StefanRohringer/Magnetic-Fin-Gripper/zeichnungen/README.md

# Zeichnungen / Drawings

**Gültig ist nur die Basis V1.8.1.** Bei den älteren Basen (V1.7, V1.8) blieben einzelne Lamellen nach einem festen Griff hängen. V1.8.1 hat mehr Luft um die Lamellen und behebt das. Ältere Basen bitte nicht mehr drucken.

**Only base V1.8.1 is valid.** With the earlier bases (V1.7, V1.8) individual lamellae could get stuck after a firm grip. V1.8.1 has more clearance around the lamellae and fixes this. Please do not print older bases.

| Datei / File | Inhalt / Content |
|---|---|
| `Massblatt_V1.8.1.pdf` / `.png` | Basis V1.8.1 (gültig) – base V1.8.1 (valid) |
| `Massblatt_Lamelle_V1.6N.pdf` / `.png` | Fin-Ray-Lamelle V1.6-N – Fin-Ray lamella V1.6-N |
| `Massblatt_W2c_Fingernagel.pdf` / `.png` | W2c-Fingernagel – W2c fingernail |
| `Loetbruecken_A0_A1.png` | Lötbrücken A0/A1 – address solder jumpers |

Die Spalte „V1.7“ / „V1.8“ im Maßblatt V1.8.1 dient nur zum Vergleich. – The V1.7 / V1.8 columns in the V1.8.1 drawing are for comparison only.
