StefanRohringer/Magnetic-Fin-Gripper/zeichnungen/Massblatt_W2c_Fingernagel.pdf

Magnet wie heute

TPU-Lamelle wie V1.6-N,
ab y 52 massiv

PLA-Nagel

93,5

## Seitenansicht ganz zu (gemessener Spalt), Schnitt durch die Lamellen

0,3

2,44

Stift Ø1,75

## Nagel und Zapfen (2:1)

1,2

21,9

## Vorderansicht, eine Basis (Greifseite)

# W2c Fin-Ray mit PLA-Fingernagel

Für sehr kleine Elektronikteile · TPU-Lamelle wie im Stand V1.8.1 (Lamelle V1.6-N) direkt in der Basis · PLA-Nagel je Basis auf beiden Lamellen, Stift aus 1,75-mm-Filament · Probe 19.10.2026 · Maße mm

## So sitzt der Nagel

Beide Lamellen einer Basis haben oben einen Zapfen (TPU).

Der Nagel wird von oben auf beide Zapfen geschoben und

mit einem Stück 1,75-mm-Filament quer durchgesteckt.

Das TPU klemmt den Stift (Loch 1,6), im PLA hat er Luft.

Der Nagel macht aus den zwei Lamellen einer Basis eine

harte Spitze; beide Sensoren dieser Seite bleiben.

Drucklage Nagel: Greiffläche auf dem Bett (Datei liegt so).

Druckteile je Greifer

W2c_Lamelle_TPU_2Stueck.stl, 2 ×

TPU 95A wie die Lamellen V1.6-N (8.1)

W2c_Nagel_PLA_2Stueck.stl, 1 ×

PLA+, Schicht 0,12 mm, 4 Wände, 100 %,

keine Stützen, Brim 3 mm, glatte Platte

Sonst

4 Magnete 4×2 N35 (neue Lamellen)

2 Stück PLA-Filament 1,75 mm, je 25 mm

keine Schrauben; Querschrauben wie heute

Zusammenbau

1. Magnete einkleben (wie V1.6-N).
2. Lamellen einsetzen, Querschrauben.
3. Nagel auf beide Zapfen schieben.
4. Filament-Stift quer durchstecken,

Enden bündig abschneiden.

Prüfung am 3D-Modell

Lamelle bis y 52 gleich wie V1.6-N.

Nagel und Lamellen überschneiden sich nicht.

Basis frei in Ruhe und bei 1,9 Federweg.

Gegenseite ganz zu frei, Spitzen 0,3 Spalt.

Grenzen

Spalt gerechnet mit 0,94 an der Nase (gemessen).

TPU gibt nach: die Spitze sitzt weniger

genau als bei einer starren Klinge.

Farben: grau Basis V1.8.1 (bleibt) · dunkel TPU-Lamelle · gelb PLA-Nagel · rot Magnet
