StefanRohringer/Magnetic-Fin-Gripper/zeichnungen/Loetbruecken_A0_A1.png

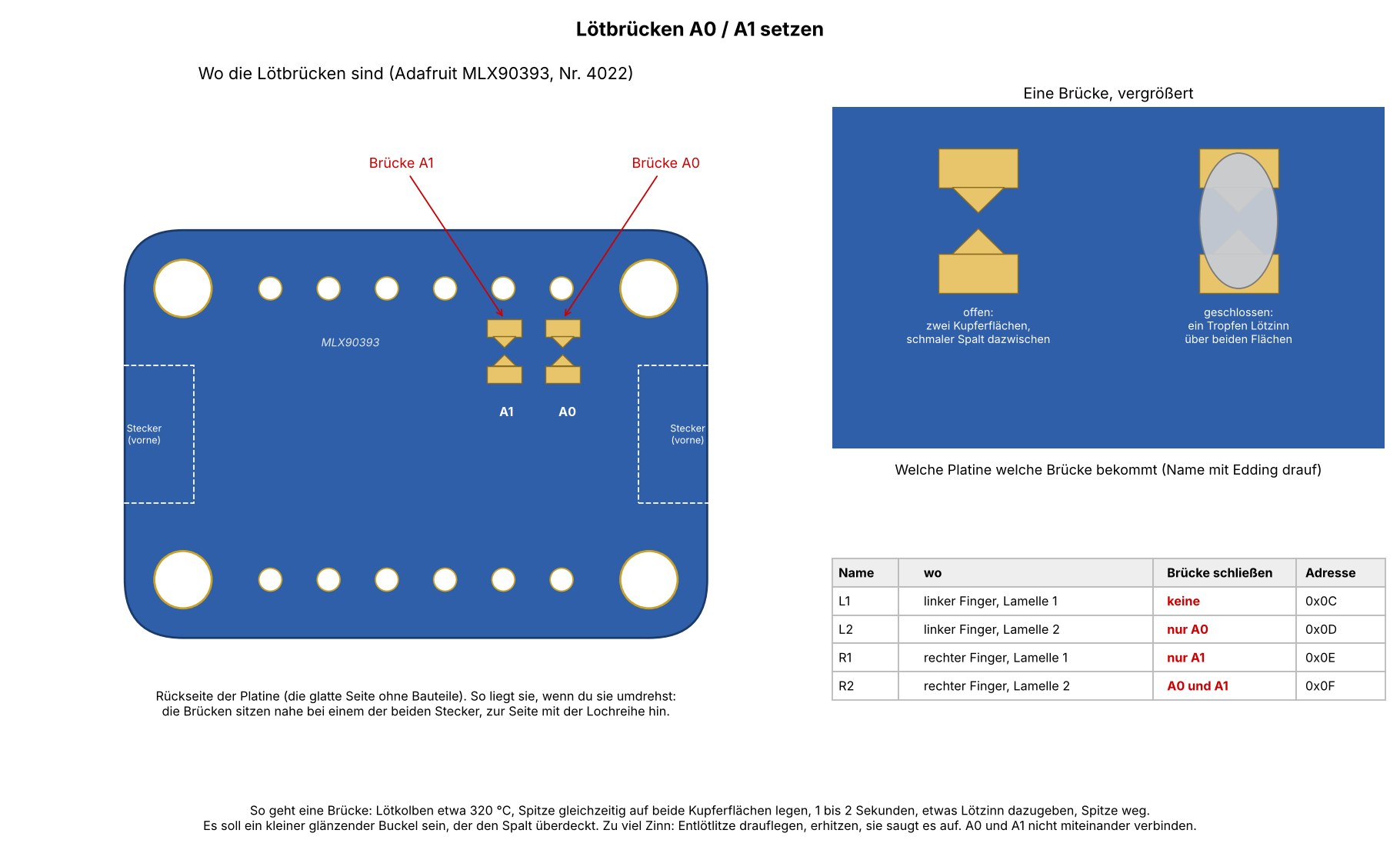
zeichnungen/Loetbruecken_A0_A1.png
