StefanRohringer/Magnetic-Fin-Gripper/zeichnungen/Massblatt_Lamelle_V1.6N.png

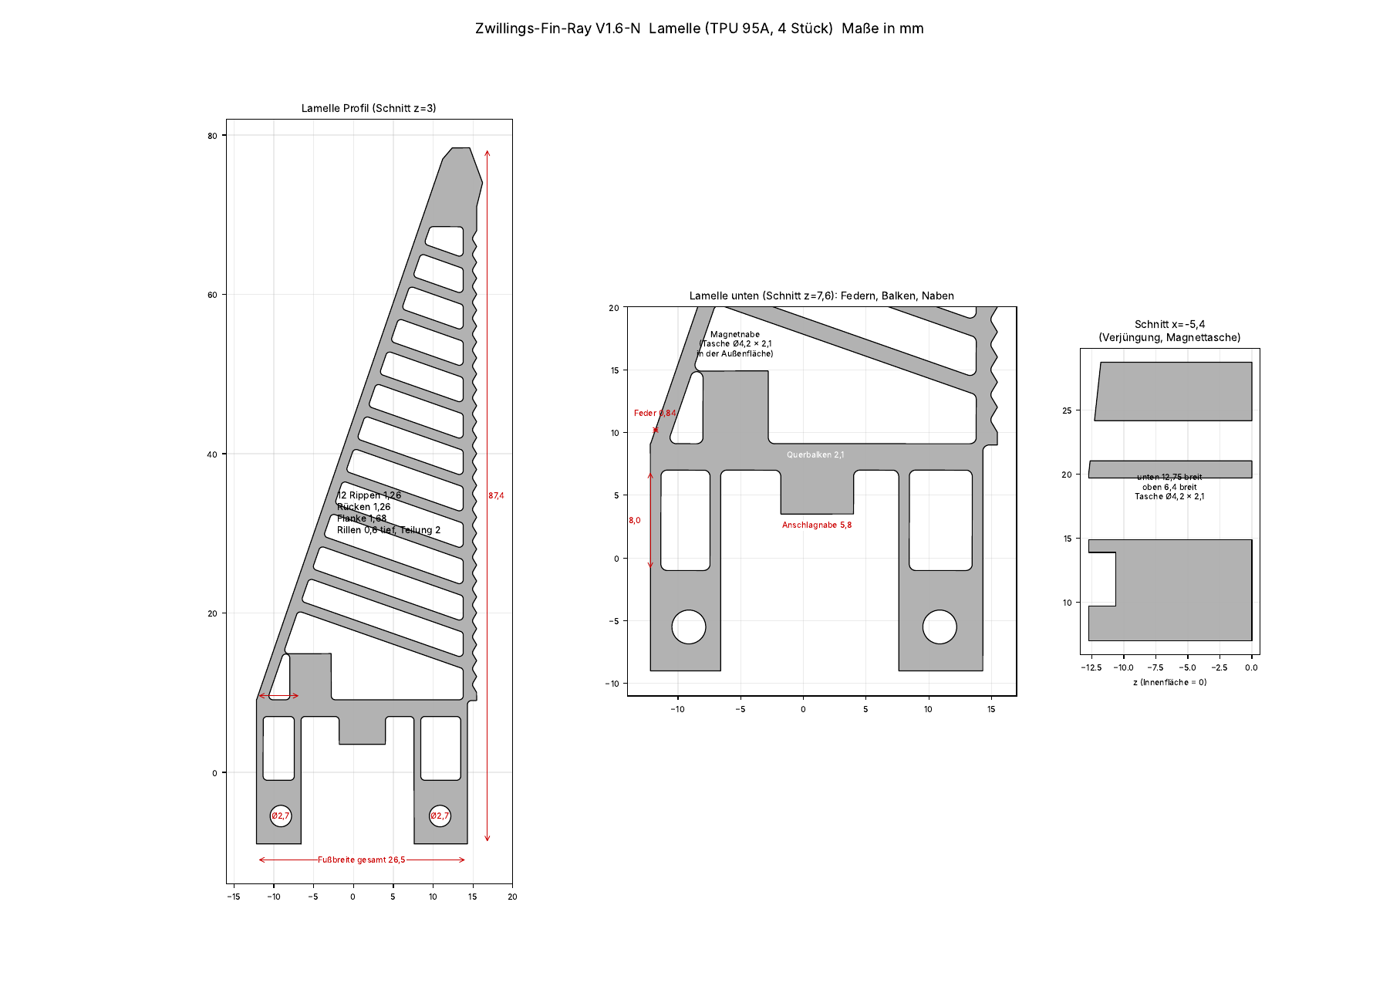
zeichnungen/Massblatt_Lamelle_V1.6N.png
