StefanRohringer/Magnetic-Fin-Gripper/zeichnungen/Massblatt_V1.8.1.png

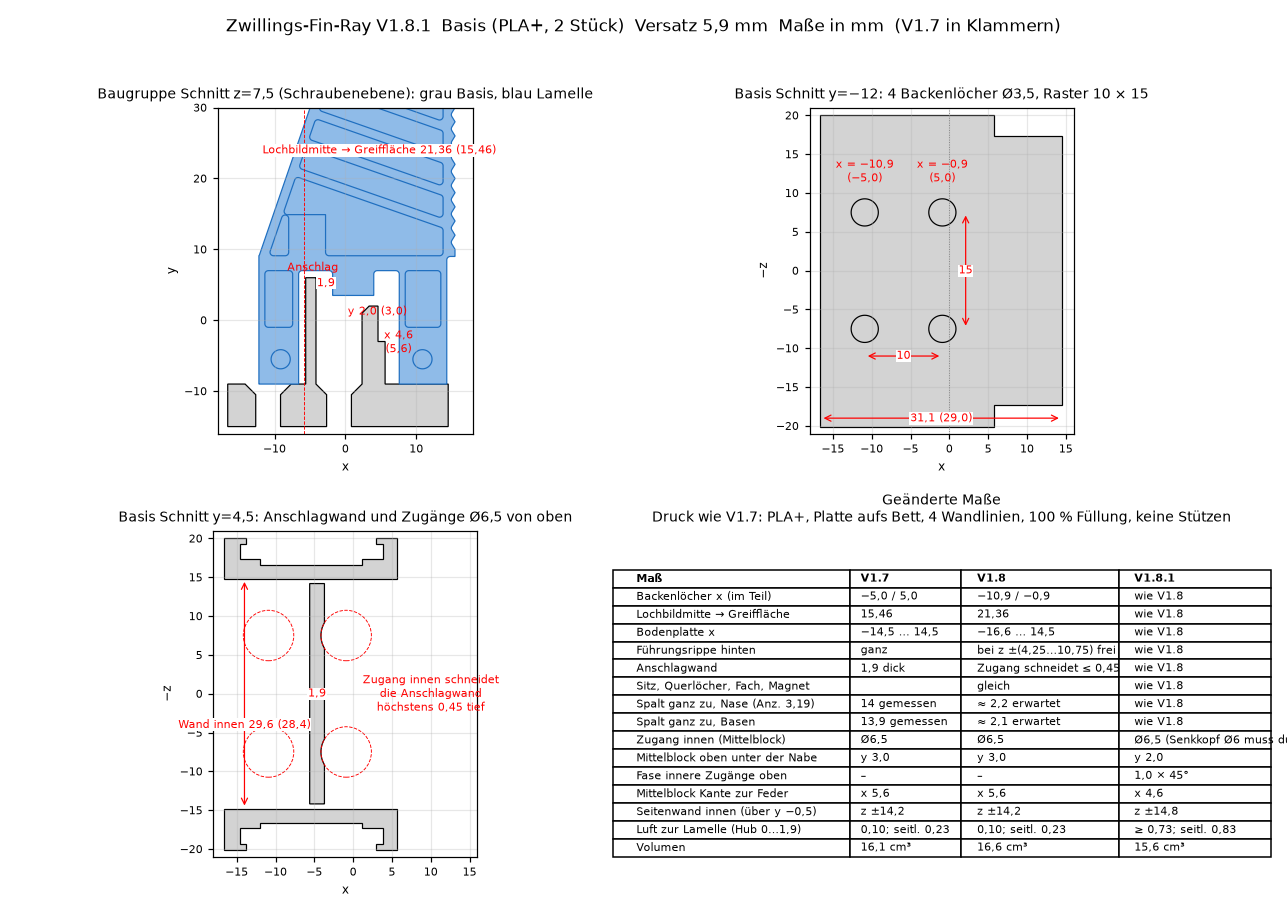
zeichnungen/Massblatt_V1.8.1.png
