StefanRohringer/Magnetic-Fin-Gripper/zeichnungen/Massblatt_W2c_Fingernagel.png

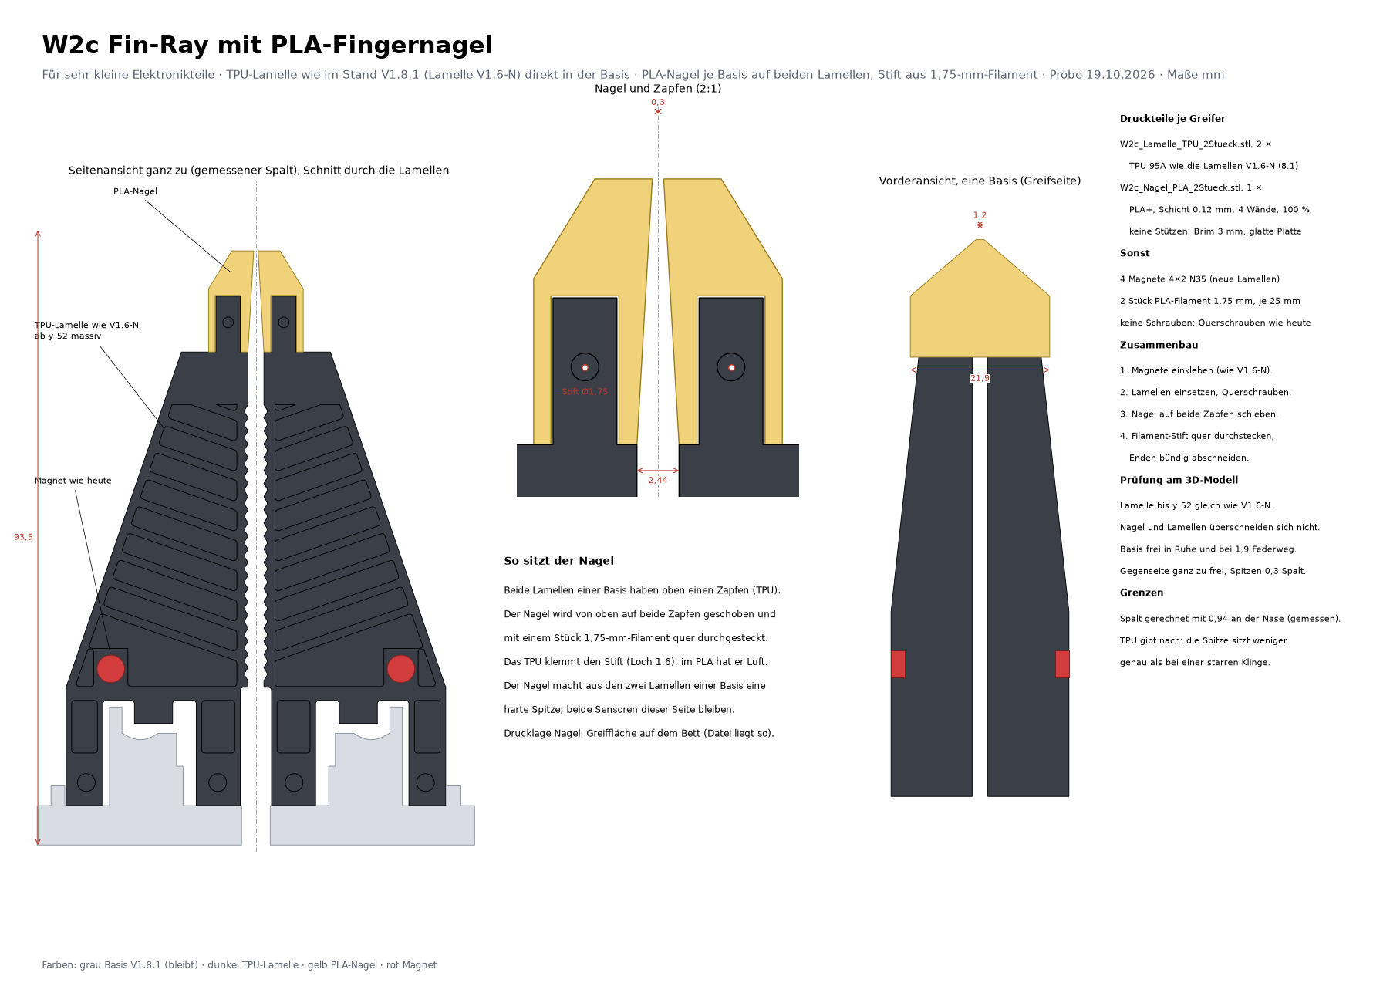
zeichnungen/Massblatt_W2c_Fingernagel.png
