StefanRohringer/Magnetic-Fin-Gripper/druck/Basis_V1.8.1_PLA.stl

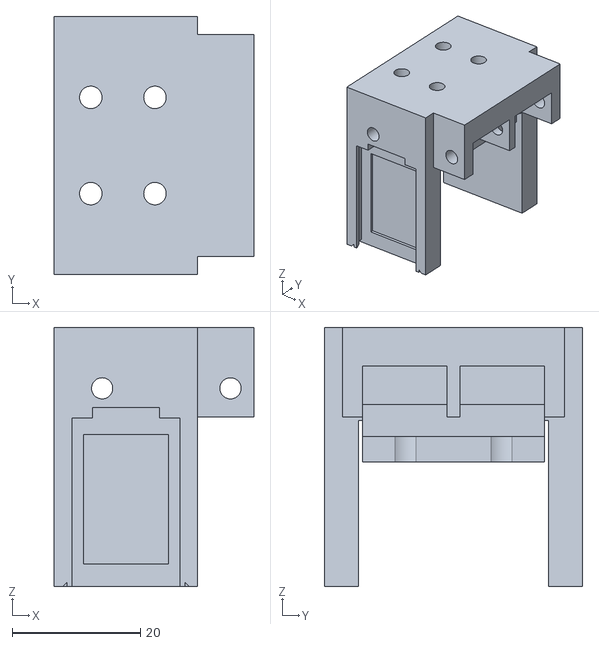
[picture p6: CAD file, 2026-10-20]
druck/Basis_V1.8.1_PLA.stl
31.1 x 40.2 x 40.4
