StefanRohringer/Magnetic-Fin-Gripper/druck/Lamellen_V1.6N_TPU_2Stueck.stl

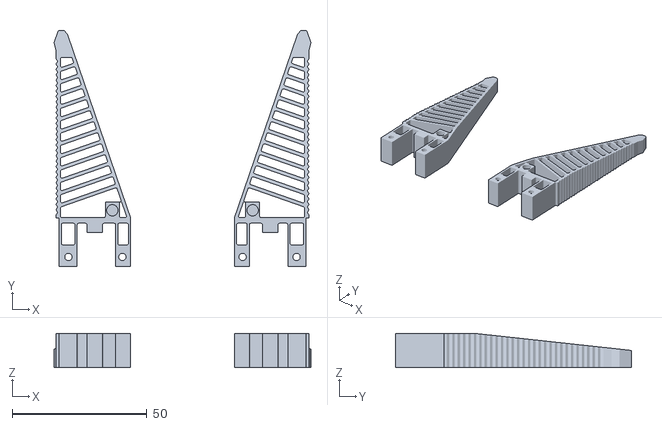
[picture p7: CAD file, 2026-10-20]
druck/Lamellen_V1.6N_TPU_2Stueck.stl
95.2 x 87.4 x 12.8
