StefanRohringer/Magnetic-Fin-Gripper/druck/W2c_Lamelle_TPU_2Stueck.stl

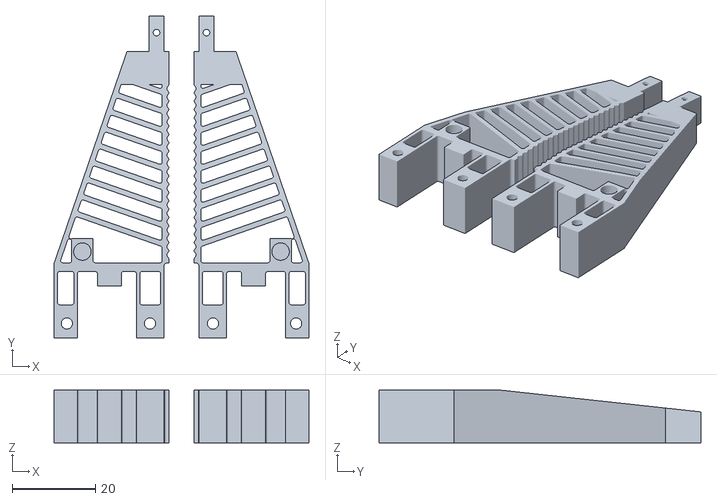
[picture p8: CAD file, 2026-10-20]
druck/W2c_Lamelle_TPU_2Stueck.stl
61.3 x 77.5 x 12.8
