StefanRohringer/Magnetic-Fin-Gripper/druck/W2c_Nagel_PLA_2Stueck.stl

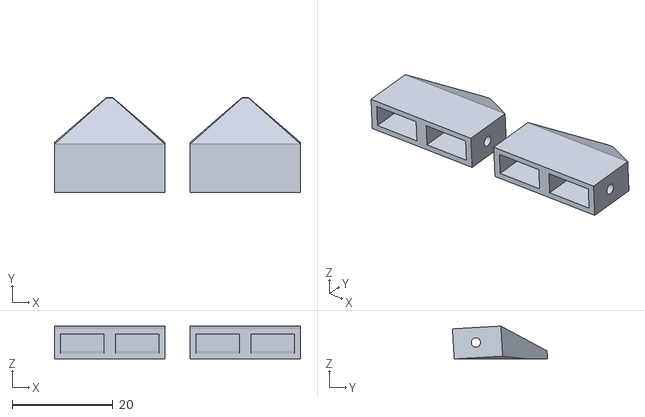
[picture p9: CAD file, 2026-10-20]
druck/W2c_Nagel_PLA_2Stueck.stl
48.8 x 18.9 x 6.53
