StefanRohringer/Magnetic-Fin-Gripper/zeichnungen/Massblatt_Lamelle_V1.6N.pdf

## Lamelle Profil (Schnitt z=3)

# Zwillings-Fin-Ray V1.6-N Lamelle (TPU 95A, 4 Stück) Maße in mm

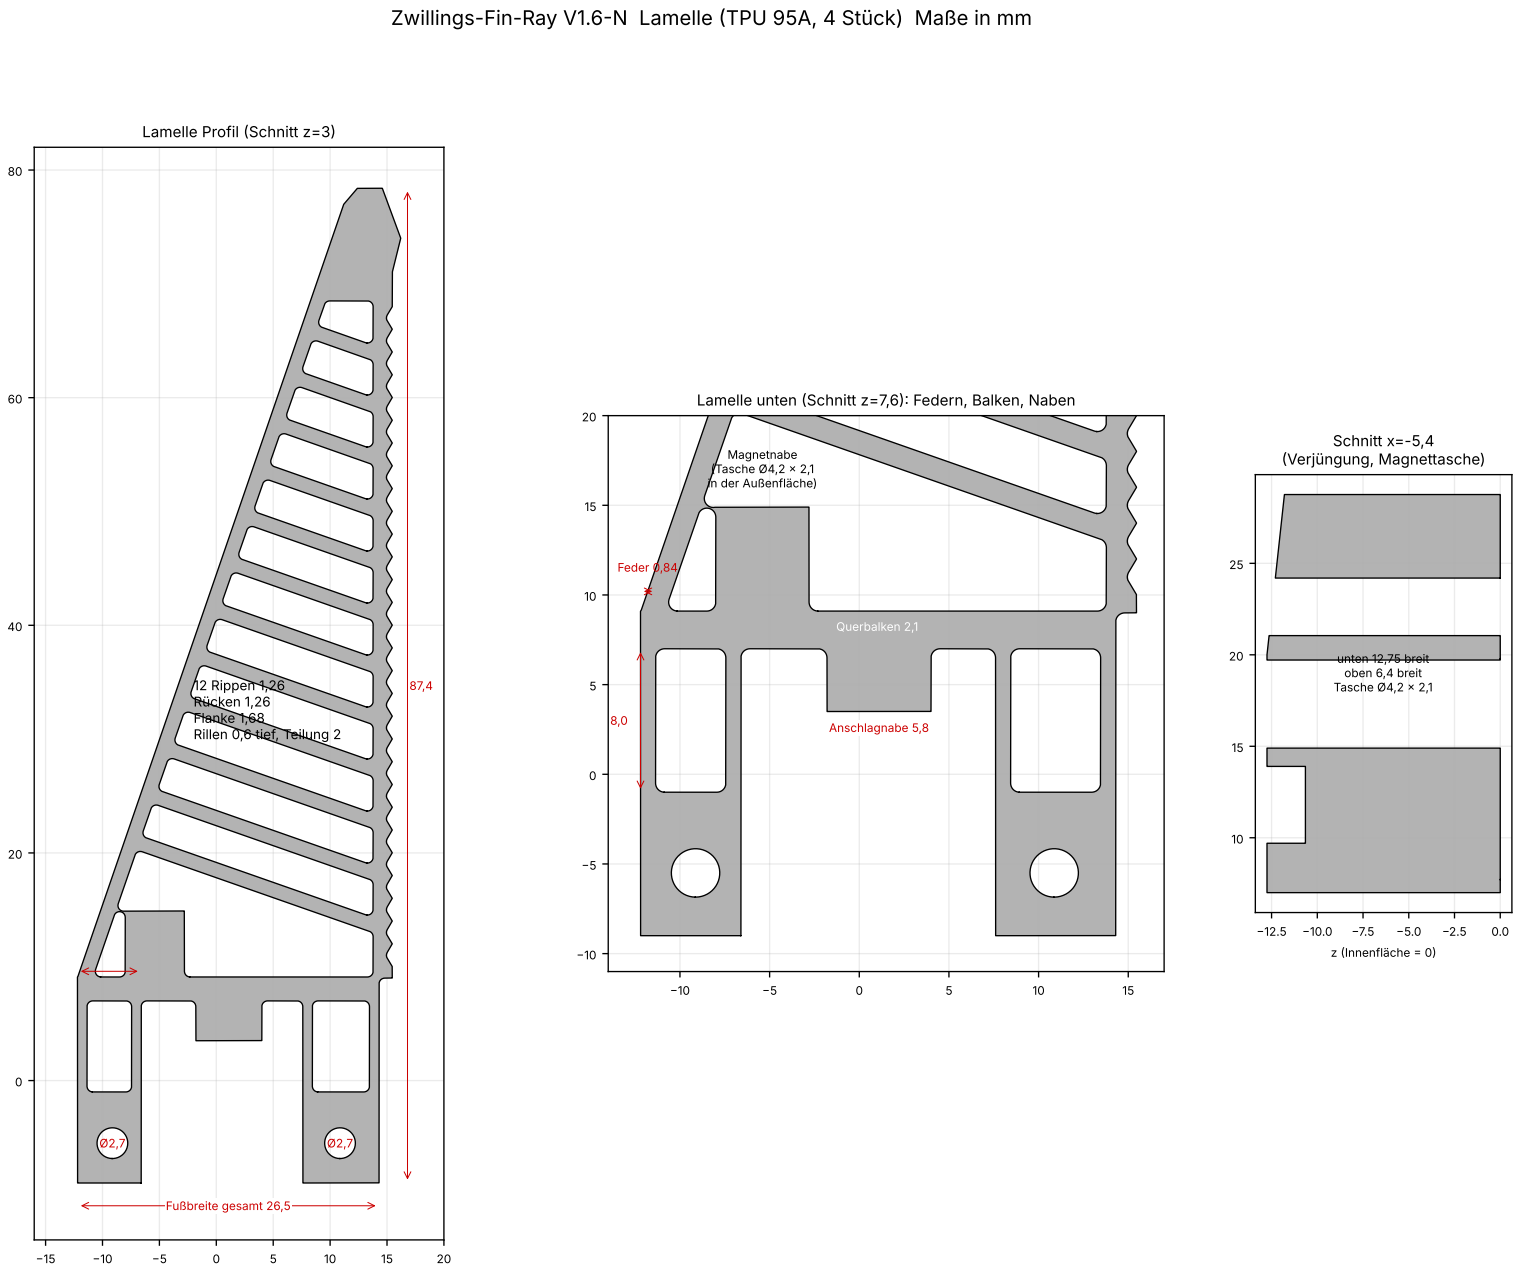
[picture p10: page 1]
Fußbreite gesamt 26,5; z (Innenfläche = 0); unten 12,75 breit oben 6,4 breit Tasche Ø4,2 × 2,1; Schnitt x=-5,4 (Verjüngung, Magnettasche)

Lamelle unten (Schnitt z=7,6): Federn, Balken, Naben

Magnetnabe (Tasche Ø4,2 × 2,1 in der Außenfläche)

Feder 0,84

Querbalken 2,1

12 Rippen 1,26
Rücken 1,26
Flanke 1,68
Rillen 0,6 tief, Teilung 2

8,0 | | Anschlagnabe 5,8
