StefanRohringer/Magnetic-Fin-Gripper/zeichnungen/Massblatt_V1.8.1.pdf

## Baugruppe Schnitt z=7,5 (Schraubenebene): grau Basis, blau Lamelle

## Basis Schnitt y=−12: 4 Backenlöcher Ø3,5, Raster 10 × 15

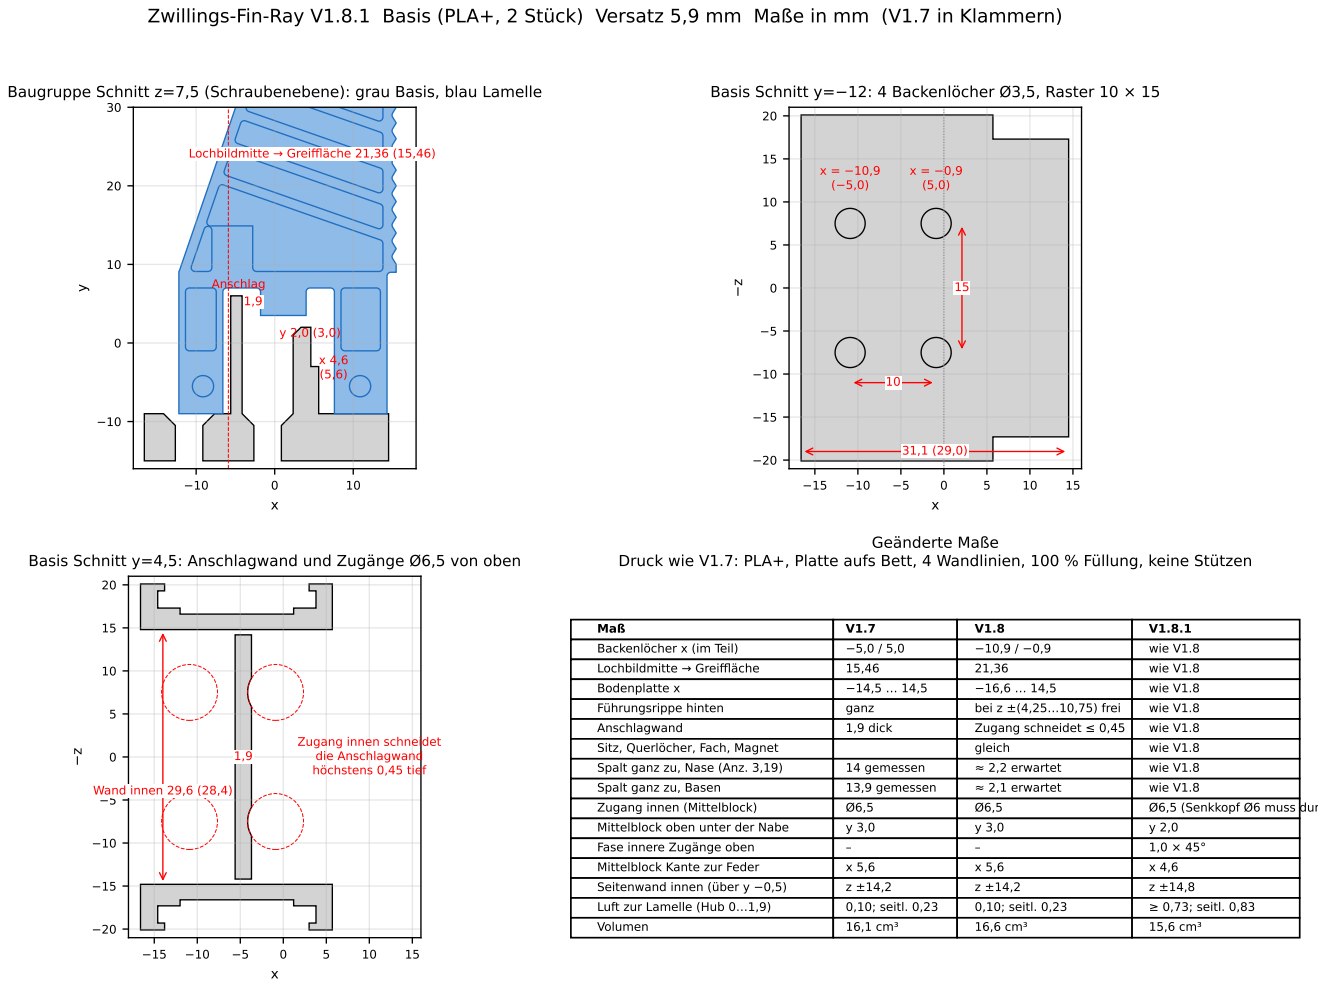
[picture p11: page 1]
Lochbildmitte; → Greiffläche; Wand; innen 29,6; Maß; Backenlöcher x (im Teil); wie V1.8; Lochbildmitte → Greiffläche; Bodenplatte x; Führungsrippe hinten; ganz; bei z ±(4,25…10,75) frei; Anschlagwand; 1,9 dick; Zugang schneidet ≤ 0,45; Sitz, Querlöcher, Fach, Magnet; gleich; Spalt ganz zu, Nase (Anz. 3,19); 14 gemessen; ≈ 2,2 erwartet; Spalt ganz zu, Basen; 13,9 gemessen; ≈ 2,1 erwartet; Zugang innen (Mittelblock); Ø6,5 (Senkkopf Ø6 muss durch); Mittelblock oben unter der Nabe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

Zwillings-Fin-Ray V1.8.1 Basis (PLA+, 2 Stück) Versatz 5,9 mm Maße in mm (V1.7 in Klammern)

Anschlag | 1,9 | y 2,0 (3,0)

Basis Schnitt y=4,5: Anschlagwand und Zugänge Ø6,5 von oben

Druck wie V1.7: PLA+, Platte aufs Bett, 4 Wandlinien, 100 % Füllung, keine Stützen

Zugang innen schneidet
die Anschlagwand
höchstens 0,45 tief
