StefanRohringer/Magnetic-Fin-Gripper/(commit log)

2026-10-20 Magnetic-Fin-Gripper: Zwillings-Fin-Ray mit Magnet-Tastsinn (Basis V1.8.1, Lamellen V1.6-N, W2c), Pico- und PC-Software, 3D-Vorführung
    [Basis_V1.8.1_PLA.stl, Lamellen_V1.6N_TPU_2Stueck.stl, W2c_Lamelle_TPU_2Stueck.stl, W2c_Nagel_PLA_2Stueck.stl]
2026-10-20 Prüfung: Voraussetzungen (python3-venv, python3-tk, dialout), veraltete Testangaben und gemessene Feldänderung korrigiert
2026-10-20 Copyright- und Lizenzkopf (SPDX) in allen Quelldateien
2026-10-20 Maßblätter: Basis V1.8.1, Lamelle V1.6-N, W2c-Fingernagel
